AP-Elektronica-ICT/iot18-EP/README.md

# Internet of Things - Logistiek Tracking (Naam WIP)

## Groepsleden
Geentjens Wim - Trackingsoftware developer  
Knaepkens Tom - Team leader + Trackinghardware developer  
Scheyltjens Yorick - Backend webdeveloper  
Cools Jens - Frontend webdeveloper  

## Documentatie

Leg hier de link naar de nuttige documentatie
