AP-Elektronica-ICT/iot18-EP/doc/Diagrammen/HardwareFlowchart.png

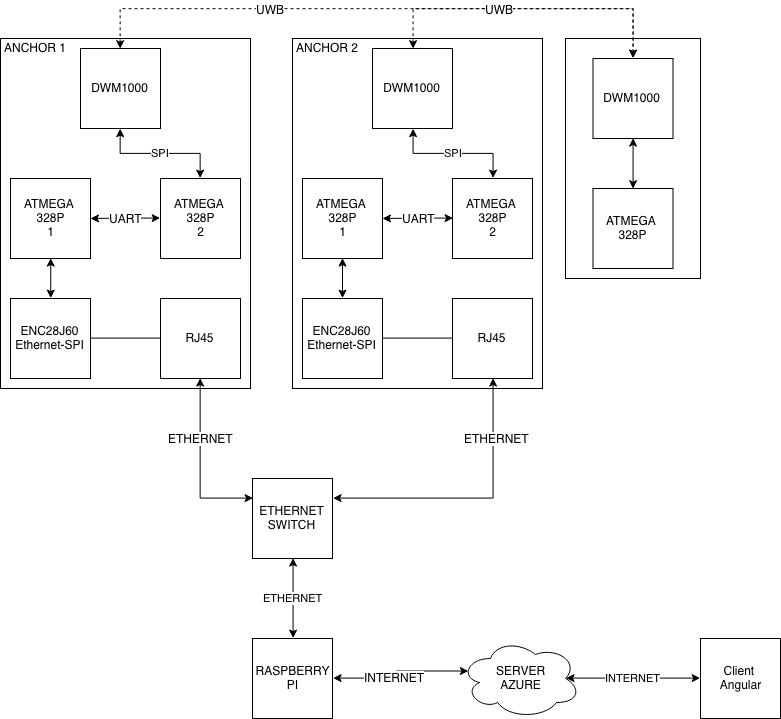
doc/Diagrammen/HardwareFlowchart.png
