AP-Elektronica-ICT/iot18-EP/src/Client/Plattegrond.png

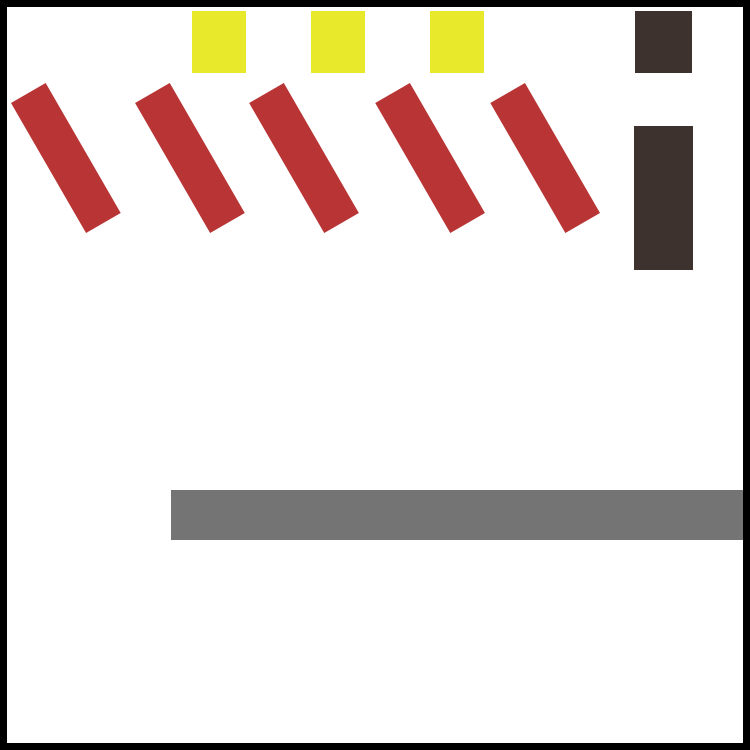
src/Client/Plattegrond.png
