AP-Elektronica-ICT/iot18-EP/src/Client/src/assets/images/map.PNG

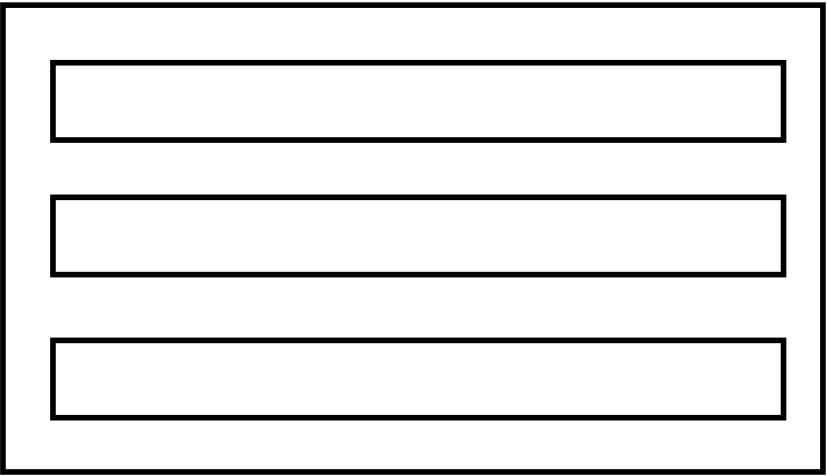
src/Client/src/assets/images/map.PNG
