AP-Elektronica-ICT/iot18-EP/src/DWM1000ConnectionSchematic.png

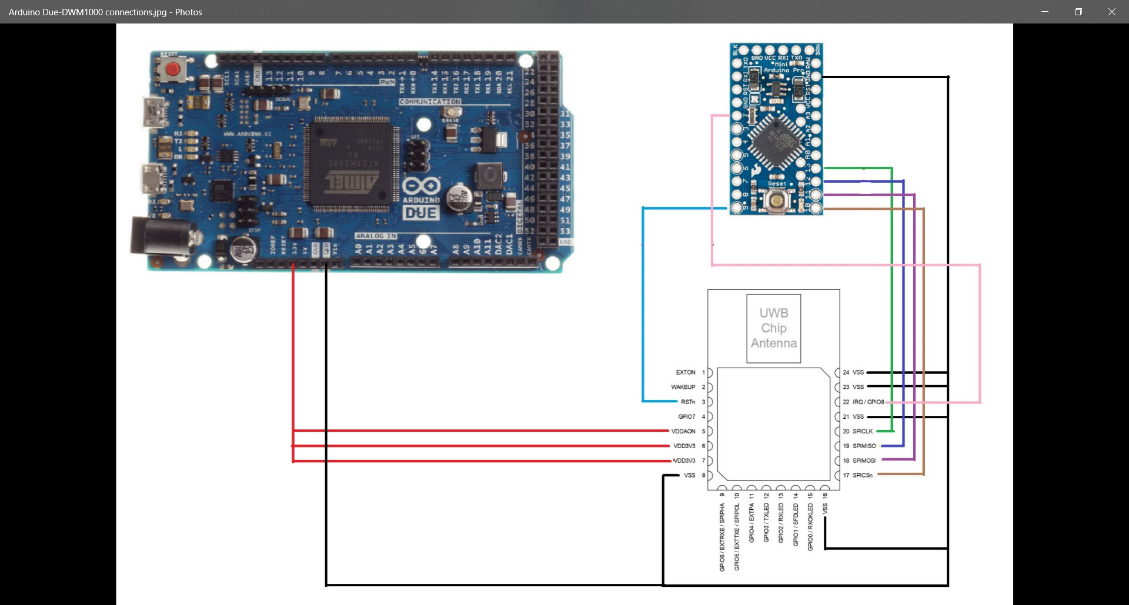
src/DWM1000ConnectionSchematic.png
