AP-Elektronica-ICT/iot18-EP/src/Anchor/PCB/Onderdelenlijst.xlsx

Onderdeel | Waarde | Package | Al in bezit | Juist package check | Eigen/School | Beschrijving | Opmerking
C1 | 100nF | SMD0805 | NEE | JA | SCHOOL | Aan RJ45
C2 | 100nF | SMD0805 | NEE | JA | SCHOOL | Aan RJ45
C3 | 18pF | SMD0805 | JA | JA | SCHOOL | Crystal ATMEGA1
C4 | 18pF | SMD0805 | JA | JA | SCHOOL | Crystal ATMEGA1
C5 | 18pF | SMD0805 | JA | JA | SCHOOL | Crystal ATMEGA2
C6 | 18pF | SMD0805 | JA | JA | SCHOOL | Crystal ATMEGA2
C7 | 10uF | SMD0805 | NEE | JA | SCHOOL | VCAP ENC28J60
C8 | 18pF | SMD0805 | JA | JA | SCHOOL | Crystal ENCJ2860
C9 | 18pF | SMD0805 | JA | JA | SCHOOL | Crystal ENCJ2860
C10 | 100nF | SMD0805 | NEE | JA | SCHOOL | RESET ATMEGA1
C11 | 100nF | SMD0805 | NEE | JA | SCHOOL | RESET ATMEGA2
D1 | BLAUW | SMD1206 | JA | JA | EIGEN | POWER
D2 | ROOD | SMD1206 | JA | JA | EIGEN | STATUS
D3 | GEEL | SMD1206 | JA | JA | EIGEN | TX
D4 | GROEN | SMD1206 | JA | JA | EIGEN | RX
D5 | GEEL | SMD1206 | JA | JA | EIGEN | DWM-TX
D6 | GROEN | SMD1206 | JA | JA | EIGEN | DWM-RX
IC3 | ENC28J60 | SOP65P780X200-28N | JA | JA | SCHOOL | Ethernet IC
J1 | SI-50154-F | SI-50154-F | JA | JA | SCHOOL | Ethernet Jack
J2 | ISP PROG 1 | 2x3 Pinheader | NEE | JA | SCHOOL | ISP PROG 1
J3 | ISP PROG 2 | 2x3 Pinheader | NEE | JA | SCHOOL | ISP PROG 2
J4 | PJ102AH | PJ102AH | JA | JA | EIGEN | DC Jack
MCU 1 | ATMEGA328P-AU | QFP80P900X900X120-32N | NEE | JA | SCHOOL | ATMEGA1
MCU 2 | ATMEGA328P-AU | QFP80P900X900X120-32N | NEE | JA | SCHOOL | ATMEGA2
R1 | 100 | SMD0805 | JA | JA | SCHOOL | Led Magjack
R2 | 100 | SMD0805 | JA | JA | SCHOOL | Led Magjack
R3 | 49.9 | SMD1206 | JA | JA | SCHOOL | Ethernet schema
R4 | 49.9 | SMD1206 | JA | JA | SCHOOL | Ethernet schema
R5 | 49.9 | SMD1206 | JA | JA | SCHOOL | Ethernet schema
R6 | 49.9 | SMD1206 | JA | JA | SCHOOL | Ethernet schema
R7 | 10k | SMD0805 | NEE | JA | SCHOOL | RESET 1 PULLUP
R8 | 10k | SMD0805 | NEE | JA | SCHOOL | RESET 2 PULLUP
R9 | 10k | SMD0805 | NEE | JA | SCHOOL | IRQ Pulldown
R10 | 2k32 | SMD1206 | JA | JA | SCHOOL | RBIAS ENCJ2860
R11 | 330 | SMD0805 | NEE | JA | SCHOOL | SPI VOORSCHAKEL
R12 | 330 | SMD0805 | NEE | JA | SCHOOL | SPI VOORSCHAKEL
R13 | 330 | SMD0805 | NEE | JA | SCHOOL | SPI VOORSCHAKEL
R14 |  |  |  |  |  |  | Weggelaten
R15 |  |  |  |  |  |  | Weggelaten
R16 |  |  |  |  |  |  | Weggelaten
R17 | 470 | SMD1206 | JA | JA | EIGEN | R LED Power
R18 | 220 | SMD1206 | JA | JA | EIGEN | R LED RX
R19 | 270 | SMD1206 | JA | JA | EIGEN | R LED TX
R20 | 390 | SMD1206 | JA | JA | EIGEN | R LED STATUS
R21 | 270 | SMD1206 | JA | JA | EIGEN | R LED DWM-TX
R22 | 220 | SMD1206 | JA | JA | EIGEN | R LED DWM-RX
S1 | RESET 1 | MOMENTARY-SWITCH-SPST-PTH-6.0MM | JA | JA | EIGEN | Reset 1
S2 | RESET 2 | MOMENTARY-SWITCH-SPST-PTH-6.0MM | JA | JA | EIGEN | Reset 2
DC-STEPDOWN | DC-STEPDOWN | DC-STEPDOWN | JA | JA | EIGEN | Power module
DWM1000 | DWM1000 | DWM1000 | NEE | JA | SCHOOL | UWB Module
UART1 | UART1 | 1x6 Pinheader | JA | JA | EIGEN | UART1
UART2 | UART2 | 1x6 Pinheader | JA | JA | EIGEN | UART2
Y1 | 8MHz | HC49UP | NEE | JA | SCHOOL | Crystal ATMEGA1
Y2 | 8MHz | HC49UP | NEE | JA | SCHOOL | Crystal ATMEGA2
Y3 | 25MHz | HC49UP | NEE | JA | SCHOOL | Crystal ENCJ2860
