AP-Elektronica-ICT/iot18-EP/src/Tag/PCB/Onderdelenlijst.xlsx

Onderdeel | Waarde | Package | Al in bezit | Juist package check | Eigen/School
C1 | 18pF | SMD0805 | JA | JA | SCHOOL
C2 | 18pF | SMD0805 | JA | JA | SCHOOL
C3 | 100nF | SMD0805 | NEE | JA | SCHOOL
C4 | 100uF | 3.5-8 | JA | JA | SCHOOL
C5 | 10uF | 2.5-7 | JA | JA | SCHOOL
MCU 1 | ATMEGA328P-AU | QFP80P900X900X120-32N | NEE | JA | SCHOOL
J1 | ISP PROG | 2x3 Pinheader | JA | JA | SCHOOL
Q1 | 8MHz | HC49UP | NEE | JA | SCHOOL
R1 | 10k | SMD0805 | NEE | JA | SCHOOL
R2 | 10k | SMD0805 | NEE | JA | SCHOOL
S1 | RESET 1 | MOMENTARY-SWITCH-SPST-PTH-6.0MM | JA | JA | EIGEN
DWM1000 | DWM1000 | DWM1000 | JA | JA | SCHOOL
UART | UART | 1x6 Pinheader | JA | JA | SCHOOL
