AP-Elektronica-ICT/iot18-EP/src/Anchor/PCB/Anchor PCB V2.brd

## EAGLE design src/Anchor/PCB/Anchor PCB V2.brd (2018-12-08)

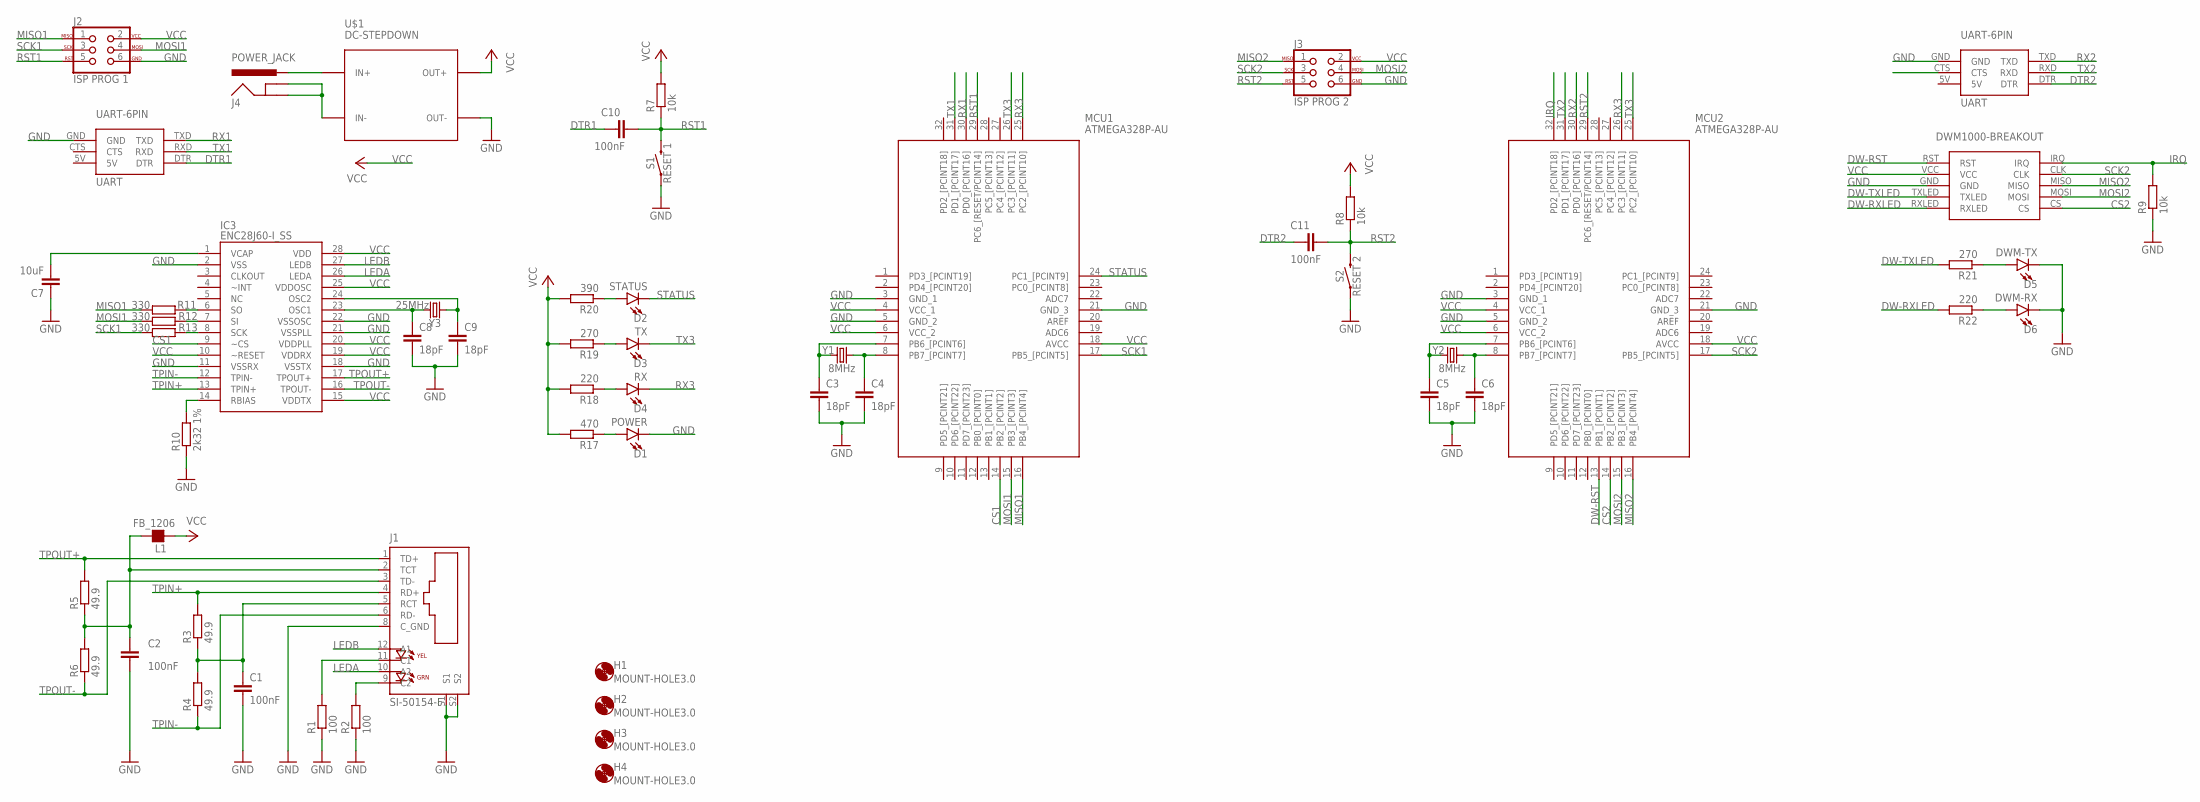
[picture p11: schematic Anchor PCB V2.sch]

Parts:
C1, C2, C10, C11: 100nF; C0805
C3, C4, C5, C6, C8, C9: 18pF; C0805
C7: 10uF; C0805
D1: POWER; LED-1206
D2: STATUS; LED-1206
D3: TX; LED-1206
D4: RX; LED-1206
D5: DWM-TX; LED-1206
D6: DWM-RX; LED-1206
H1, H2, H3, H4: MOUNT-HOLE3.0; 3,0
IC3: ENC28J60-I_SS; SOP65P780X200-28N
J1: SI-50154-F; STEWART_SI-50154-F
J2: ISP PROG 1; 2X3
J3: ISP PROG 2; 2X3
J4: POWER_JACK; POWER_JACK_PTH
L1: FB_1206; L1206
MCU1, MCU2: ATMEGA328P-AU; QFP80P900X900X120-32N
R1, R2: 100; R0805
R3, R4, R5, R6: 49.9; R1206
R7, R8, R9: 10k; R0805
R10: 2k32 1%; R1206
R11, R12, R13: 330; R0805
R17: 470; R1206
R18, R22: 220; R1206
R19, R21: 270; R1206
R20: 390; R1206
S1: RESET 1; TACTILE_SWITCH_PTH_6.0MM
S2: RESET 2; TACTILE_SWITCH_PTH_6.0MM
U$1: DC-STEPDOWN; DC-DC-STEP-DOWN-LM2596
U$2: DWM1000; DWM1000-BREAKOUT
UART1: UART1; UART-6PIN
UART2: UART2; UART-6PIN
Y1, Y2: 8MHz; HC49UP
Y3: 25MHz; HC49UP

Connections:
CS1: IC3.9 (~CS), MCU1.14 (PB2_[PCINT2])
CS2: MCU2.14 (PB2_[PCINT2]), U$2.CS
DTR1: C10.1, UART1.DTR
DTR2: C11.1, UART2.DTR
DW-RST: MCU2.13 (PB1_[PCINT1]), U$2.RST
DW-RXLED: R22.2, U$2.RXLED
DW-TXLED: R21.2, U$2.TXLED
GND: C1.2, C2.2, C3.2, C4.2, C5.2, C6.2, C7.1, C8.2, C9.2, D1.C, D5.C, D6.C, IC3.2 (VSS), IC3.11 (VSSRX), IC3.18 (VSSTX), IC3.21 (VSSPLL), IC3.22 (VSSOSC), J1.8 (C_GND), J1.S1, J1.S2, J2.6, J3.6, MCU1.3 (GND_1), MCU1.5 (GND_2), MCU1.21 (GND_3), MCU2.3 (GND_1), MCU2.5 (GND_2), MCU2.21 (GND_3), R1.1, R2.1, R9.1, R10.1, S1.1, S2.1, U$1.OUT-, U$2.GND, UART1.GND, UART2.GND
IN+: J4.PWR, U$1.IN+
IN-: J4.GND, J4.GNDBREAK, U$1.IN-
IRQ: MCU2.32 (PD2_[PCINT18]), R9.2, U$2.IRQ
LEDA: IC3.26 (LEDA), J1.10 (A2)
LEDB: IC3.27 (LEDB), J1.12 (A1)
MISO1: J2.1, MCU1.16 (PB4_[PCINT4]), R11.2
MISO2: J3.1, MCU2.16 (PB4_[PCINT4]), U$2.MISO
MOSI1: J2.4, MCU1.15 (PB3_[PCINT3]), R12.2
MOSI2: J3.4, MCU2.15 (PB3_[PCINT3]), U$2.MOSI
unnamed: J1.11 (C1), R1.2
unnamed: J1.9 (C2), R2.2
unnamed: C3.1, MCU1.7 (PB6_[PCINT6]), Y1.2
unnamed: C4.1, MCU1.8 (PB7_[PCINT7]), Y1.1
unnamed: C5.1, MCU2.7 (PB6_[PCINT6]), Y2.1
unnamed: C6.1, MCU2.8 (PB7_[PCINT7]), Y2.2
unnamed: C7.2, IC3.1 (VCAP)
unnamed: IC3.14 (RBIAS), R10.2
unnamed: C8.1, IC3.23 (OSC1), Y3.2
unnamed: C9.1, IC3.24 (OSC2), Y3.1
unnamed: IC3.6 (SO), R11.1
unnamed: C1.1, J1.5 (RCT), R3.1, R4.2
unnamed: C2.1, J1.2 (TCT), L1.2, R5.1, R6.2
unnamed: IC3.7 (SI), R12.1
unnamed: IC3.8 (SCK), R13.1
unnamed: D5.A, R21.1
unnamed: D4.A, R18.1
unnamed: D2.A, R20.1
unnamed: D3.A, R19.1
unnamed: D6.A, R22.1
unnamed: D1.A, R17.1
RST1: C10.2, J2.5, MCU1.29 (PC6_[RESET/PCINT14]), R7.1, S1.3 (2)
RST2: C11.2, J3.5, MCU2.29 (PC6_[RESET/PCINT14]), R8.1, S2.3 (2)
RX1: MCU1.30 (PD0_[PCINT16]), UART1.TXD
RX2: MCU2.30 (PD0_[PCINT16]), UART2.TXD
RX3: D4.C, MCU1.25 (PC2_[PCINT10]), MCU2.26 (PC3_[PCINT11])
SCK1: J2.3, MCU1.17 (PB5_[PCINT5]), R13.2
SCK2: J3.3, MCU2.17 (PB5_[PCINT5]), U$2.CLK
STATUS: D2.C, MCU1.24 (PC1_[PCINT9])
TPIN+: IC3.13 (TPIN+), J1.4 (RD+), R3.2
TPIN-: IC3.12 (TPIN-), J1.6 (RD-), R4.1
TPOUT+: IC3.17 (TPOUT+), J1.1 (TD+), R5.2
TPOUT-: IC3.16 (TPOUT-), J1.3 (TD-), R6.1
TX1: MCU1.31 (PD1_[PCINT17]), UART1.RXD
TX2: MCU2.31 (PD1_[PCINT17]), UART2.RXD
TX3: D3.C, MCU1.26 (PC3_[PCINT11]), MCU2.25 (PC2_[PCINT10])
VCC: IC3.10 (~RESET), IC3.15 (VDDTX), IC3.19 (VDDRX), IC3.20 (VDDPLL), IC3.25 (VDDOSC), IC3.28 (VDD), J2.2, J3.2, L1.1, MCU1.4 (VCC_1), MCU1.6 (VCC_2), MCU1.18 (AVCC), MCU2.4 (VCC_1), MCU2.6 (VCC_2), MCU2.18 (AVCC), R7.2, R8.2, R17.2, R18.2, R19.2, R20.2, U$1.OUT+, U$2.VCC

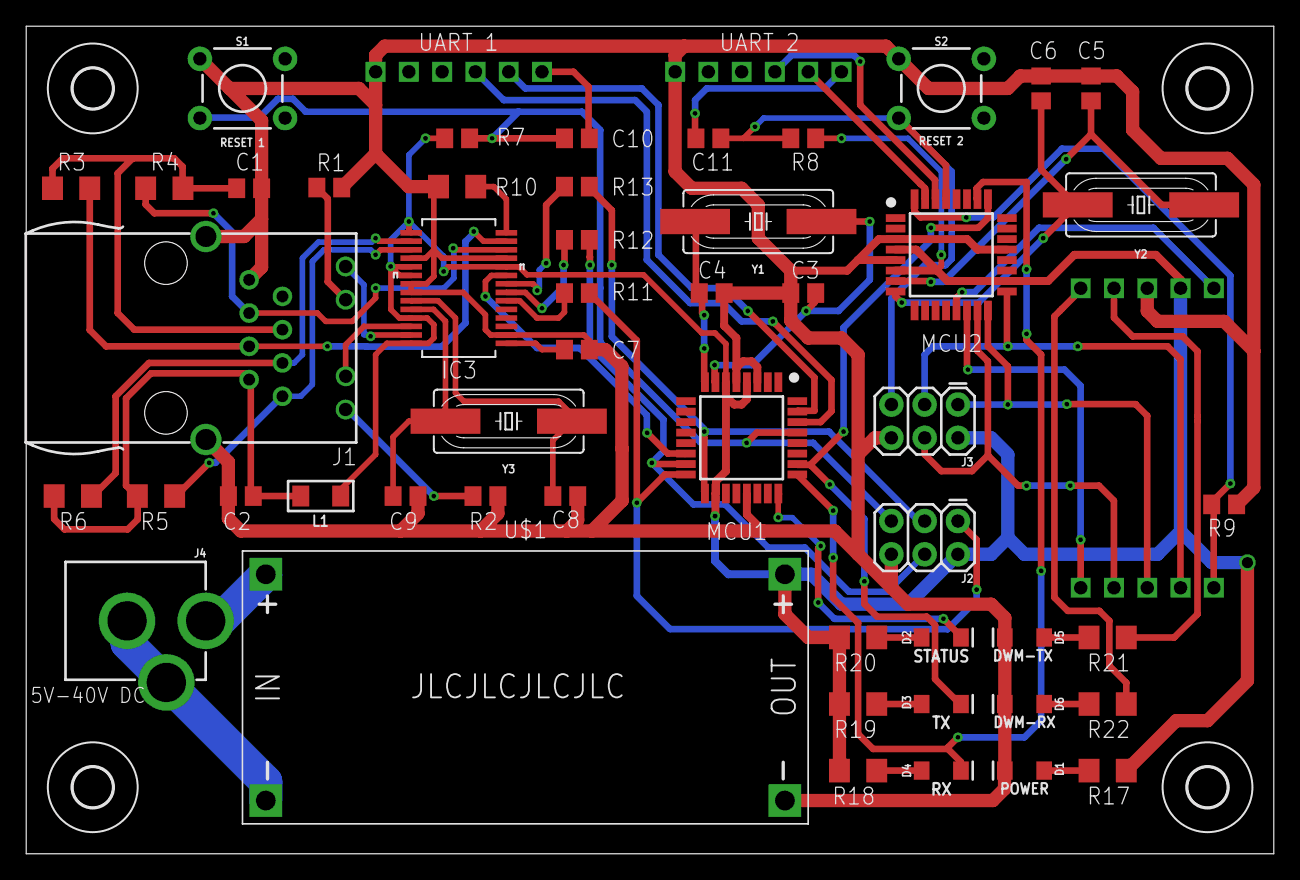
[picture p12: board Anchor PCB V2.brd from above]

Board: 2 copper layers, 95.2 x 63.2 mm, 57 parts (0 on the bottom side), 54 nets.
