AP-Elektronica-ICT/iot18-EP/src/DC-DC DIY/DC-DC DIY/Schematic.brd

## EAGLE design src/DC-DC DIY/DC-DC DIY/Schematic.brd (2018-12-08)

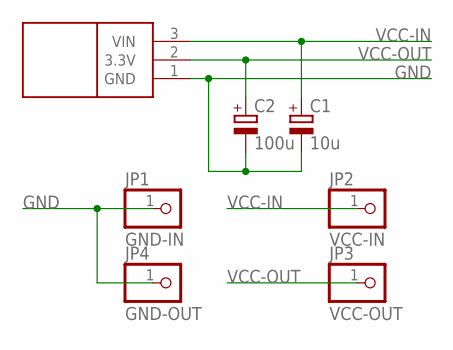
[picture p13: schematic Schematic.sch]

Parts:
C1: 10u; E2,5-7
C2: 100u; E3,5-8
JP1: GND-IN; 1X01
JP2: VCC-IN; 1X01
JP3: VCC-OUT; 1X01
JP4: GND-OUT; 1X01
U$1: LD33VHORIZONTAL; TO220

Connections:
GND: C1.-, C2.-, JP1.1, JP4.1, U$1.1 (GND)
VCC-IN: C1.+, JP2.1, U$1.3 (VIN)
VCC-OUT: C2.+, JP3.1, U$1.2 (3.3V)

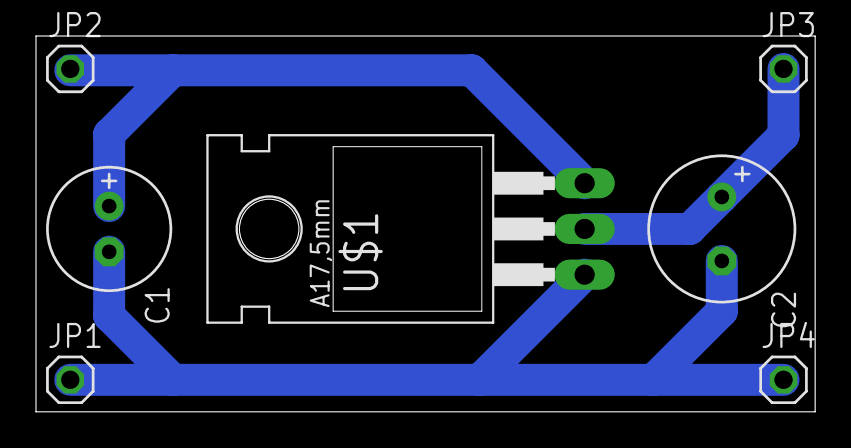
[picture p14: board src/DC-DC DIY/DC-DC DIY/Schematic.brd from above]

Board: 2 copper layers, 43.3 x 20.9 mm, 7 parts (0 on the bottom side), 3 nets.
