AP-Elektronica-ICT/iot18-EP/src/DWM1000 Breakout PCB/DWM1000 Breakout/Schematic.brd

## EAGLE design src/DWM1000 Breakout PCB/DWM1000 Breakout/Schematic.brd (2018-10-24, an earlier design)

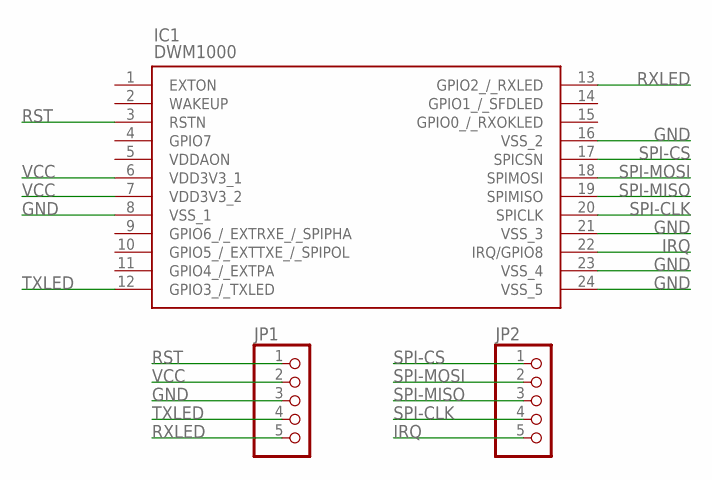
[picture p15: schematic Schematic.sch]

Parts:
IC1: DWM1000
JP1, JP2: PINHD-1X5; 1X05

Connections:
GND: IC1.8 (VSS_1), IC1.16 (VSS_2), IC1.21 (VSS_3), IC1.23 (VSS_4), IC1.24 (VSS_5), JP1.3
IRQ: IC1.22 (IRQ/GPIO8), JP2.5
RST: IC1.3 (RSTN), JP1.1
RXLED: IC1.13 (GPIO2_/_RXLED), JP1.5
SPI-CLK: IC1.20 (SPICLK), JP2.4
SPI-CS: IC1.17 (SPICSN), JP2.1
SPI-MISO: IC1.19 (SPIMISO), JP2.3
SPI-MOSI: IC1.18 (SPIMOSI), JP2.2
TXLED: IC1.12 (GPIO3_/_TXLED), JP1.4
VCC: IC1.6 (VDD3V3_1), IC1.7 (VDD3V3_2), JP1.2

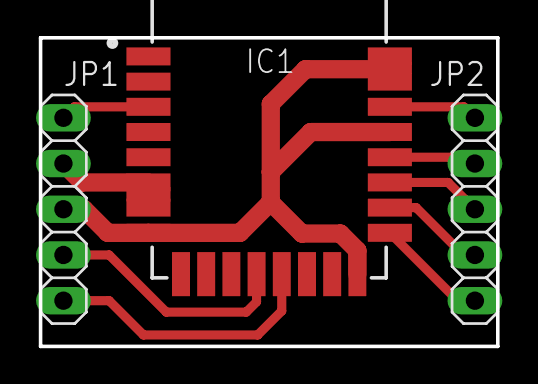
[picture p16: board src/DWM1000 Breakout PCB/DWM1000 Breakout/Schematic.brd from above]

Board: 2 copper layers, 25.4 x 17.1 mm, 3 parts (0 on the bottom side), 10 nets.
