AP-Elektronica-ICT/iot18-EP/src/Tag/PCB/Tag PCB V1.sch

## EAGLE design src/Tag/PCB/Tag PCB V1.sch (2018-11-14)

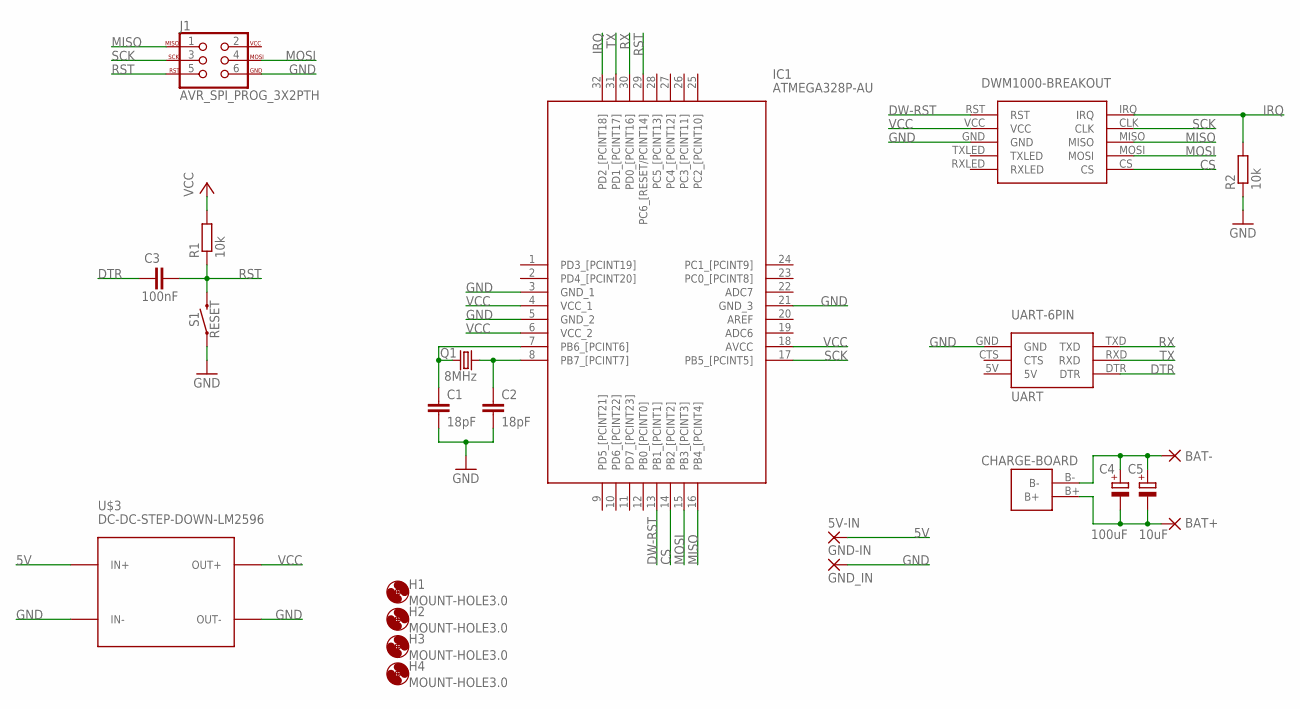
[picture p17: schematic Tag PCB V1.sch]

Parts:
5V-IN: 2,15/1,0
BAT+: 2,15/1,0
BAT-: 2,15/1,0
C1, C2: 18pF; C0805
C3: 100nF; C0805
C4: 100uF; E3,5-8
C5: 10uF; E2,5-7
GND-IN: GND_IN; 2,15/1,0
H1, H2, H3, H4: MOUNT-HOLE3.0; 3,0
IC1: ATMEGA328P-AU; QFP80P900X900X120-32N
J1: AVR_SPI_PROG_3X2PTH; 2X3
Q1: 8MHz; HC49UP
R1, R2: 10k; R0805
S1: RESET; TACTILE_SWITCH_PTH_6.0MM
U$1: DWM1000-BREAKOUT
U$2: UART-6PIN
U$3: DC-DC-STEP-DOWN-LM2596
U$4: 18650-CHARGE-5V-OUT

Connections:
5V: 5V-IN.1, U$3.IN+
CS: IC1.14 (PB2_[PCINT2]), U$1.CS
DTR: C3.1, U$2.DTR
DW-RST: IC1.13 (PB1_[PCINT1]), U$1.RST
GND: C1.2, C2.2, GND-IN.1, IC1.3 (GND_1), IC1.5 (GND_2), IC1.21 (GND_3), J1.6, R2.1, S1.1, U$1.GND, U$2.GND, U$3.IN-, U$3.OUT-
IRQ: IC1.32 (PD2_[PCINT18]), R2.2, U$1.IRQ
MISO: IC1.16 (PB4_[PCINT4]), J1.1, U$1.MISO
MOSI: IC1.15 (PB3_[PCINT3]), J1.4, U$1.MOSI
unnamed: BAT-.1, C4.+, C5.+, U$4.B-
unnamed: BAT+.1, C4.-, C5.-, U$4.B+
unnamed: C2.1, IC1.8 (PB7_[PCINT7]), Q1.2
unnamed: C1.1, IC1.7 (PB6_[PCINT6]), Q1.1
RST: C3.2, IC1.29 (PC6_[RESET/PCINT14]), J1.5, R1.1, S1.3 (2)
RX: IC1.30 (PD0_[PCINT16]), U$2.TXD
SCK: IC1.17 (PB5_[PCINT5]), J1.3, U$1.CLK
TX: IC1.31 (PD1_[PCINT17]), U$2.RXD
VCC: IC1.4 (VCC_1), IC1.6 (VCC_2), IC1.18 (AVCC), R1.2, U$1.VCC, U$3.OUT+

Notes on the sheet:
CHARGE-BOARD
