AP-Elektronica-ICT/iot18-EP/src/Anchor/Software/AnchorV3/AnchorV3.ino

#include <SPI.h>
#include <DW1000.h>
#include <EtherCard.h>


//Ethernet 
static byte mymac[] = { 0x74, 0x69, 0x69, 0x2D, 0x30, 0x31 };
static byte myip[] = { 192, 168, 3, 3 }; //IP
static byte gwip[] = { 192, 168, 3, 2 }; //Gateway
static byte hisip[] = { 192, 168, 3, 2   }; //Destination
const char website[] PROGMEM = "192.168.3.2"; //Destination
byte Ethernet::buffer[300];   // a very small tcp/ip buffer is enough here
Stash stash;
static long timer;
static byte session;



// connection pins
const uint8_t PIN_RST = 9; // reset pin
const uint8_t PIN_IRQ = 2; // irq pin
const uint8_t PIN_SS = SS; // spi select pin

// messages used in the ranging protocol
// TODO replace by enum
#define POLL 0
#define POLL_ACK 1
#define RANGE 2
#define RANGE_REPORT 3
#define RANGE_FAILED 255
// message flow state
volatile byte expectedMsgId = POLL;
// message sent/received state
volatile boolean sentAck = false;
volatile boolean receivedAck = false;
// protocol error state
boolean protocolFailed = false;
// timestamps to remember
DW1000Time timePollSent;
DW1000Time timePollReceived;
DW1000Time timePollAckSent;
DW1000Time timePollAckReceived;
DW1000Time timeRangeSent;
DW1000Time timeRangeReceived;
// last computed range/time
DW1000Time timeComputedRange;
// data buffer
#define LEN_DATA 17
byte data[LEN_DATA];
// watchdog and reset period
uint32_t lastActivity;
uint32_t resetPeriod = 250;
// reply times (same on both sides for symm. ranging)
uint16_t replyDelayTimeUS = 3000;
// ranging counter (per second)
uint16_t successRangingCount = 0;
uint32_t rangingCountPeriod = 0;
float samplingRate = 0;
int teller = 0;

void sendPacket() {

  byte sd = stash.create();
  stash.print("{");
  
  stash.print("\"MAC_TAG\":");
  stash.print("\"02\"");
  stash.print(",");
  stash.print("\"MAC_ANCHOR\":");
  stash.print("\"0x74, 0x69, 0x69, 0x2D, 0x30, 0x31\"");
  stash.print(",");
  stash.print("\"DISTANCE\":");
  stash.print(teller);
  
  stash.print("}");
  stash.save();
  Stash::prepare(PSTR("POST https://$F HTTP/1.1" "\r\n"
                      "Host: $F" "\r\n"
                       "Content-Length: $D" "\r\n"
                       "Content-Type: application/json" "\r\n"
                       "\r\n"
                       "$H"),
                 website, website, stash.size(), sd);
  ether.tcpSend();
  teller++;

  
  Serial.println("Packet Send");

}


void setup() {
  // DEBUG monitoring
  Serial.begin(115200);
  delay(1000);
  Serial.println(F("### DW1000-arduino-ranging-anchor ###"));
  // initialize the driver
  DW1000.begin(PIN_IRQ, PIN_RST);
  DW1000.select(PIN_SS);
  Serial.println(F("DW1000 initialized ..."));
  // general configuration
  DW1000.newConfiguration();
  DW1000.setDefaults();
  DW1000.setDeviceAddress(1);
  DW1000.setNetworkId(10);
  DW1000.enableMode(DW1000.MODE_LONGDATA_RANGE_LOWPOWER);
  DW1000.commitConfiguration();
  Serial.println(F("Committed configuration ..."));
  // DEBUG chip info and registers pretty printed
  char msg[128];
  DW1000.getPrintableDeviceIdentifier(msg);
  Serial.print("Device ID: "); Serial.println(msg);
  DW1000.getPrintableExtendedUniqueIdentifier(msg);
  Serial.print("Unique ID: "); Serial.println(msg);
  DW1000.getPrintableNetworkIdAndShortAddress(msg);
  Serial.print("Network ID & Device Address: "); Serial.println(msg);
  DW1000.getPrintableDeviceMode(msg);
  Serial.print("Device mode: "); Serial.println(msg);
  // attach callback for (successfully) sent and received messages
  DW1000.attachSentHandler(handleSent);
  DW1000.attachReceivedHandler(handleReceived);
  // anchor starts in receiving mode, awaiting a ranging poll message
  receiver();
  noteActivity();
  // for first time ranging frequency computation
  rangingCountPeriod = millis();

  // Ethernet
  if (ether.begin(sizeof Ethernet::buffer, mymac) == 0)
    Serial.println( "Failed to access Ethernet controller");

  ether.staticSetup(myip, gwip);
  ether.copyIp(ether.hisip, hisip);
  ether.printIp("Server: ", ether.hisip);

}

void noteActivity() {
  // update activity timestamp, so that we do not reach "resetPeriod"
  lastActivity = millis();
}

void resetInactive() {
  // anchor listens for POLL
  expectedMsgId = POLL;
  receiver();
  noteActivity();
}

void handleSent() {
  // status change on sent success
  sentAck = true;
}

void handleReceived() {
  // status change on received success
  receivedAck = true;
}

void transmitPollAck() {
  DW1000.newTransmit();
  DW1000.setDefaults();
  data[0] = POLL_ACK;
  // delay the same amount as ranging tag
  DW1000Time deltaTime = DW1000Time(replyDelayTimeUS, DW1000Time::MICROSECONDS);
  DW1000.setDelay(deltaTime);
  DW1000.setData(data, LEN_DATA);
  DW1000.startTransmit();
}

void transmitRangeReport(float curRange) {
  DW1000.newTransmit();
  DW1000.setDefaults();
  data[0] = RANGE_REPORT;
  // write final ranging result
  memcpy(data + 1, &curRange, 4);
  DW1000.setData(data, LEN_DATA);
  DW1000.startTransmit();
}

void transmitRangeFailed() {
  DW1000.newTransmit();
  DW1000.setDefaults();
  data[0] = RANGE_FAILED;
  DW1000.setData(data, LEN_DATA);
  DW1000.startTransmit();
}

void receiver() {
  DW1000.newReceive();
  DW1000.setDefaults();
  // so we don't need to restart the receiver manually
  DW1000.receivePermanently(true);
  DW1000.startReceive();
}

/*
   RANGING ALGORITHMS
   ------------------
   Either of the below functions can be used for range computation (see line "CHOSEN
   RANGING ALGORITHM" in the code).
   - Asymmetric is more computation intense but least error prone
   - Symmetric is less computation intense but more error prone to clock drifts

   The anchors and tags of this reference example use the same reply delay times, hence
   are capable of symmetric ranging (and of asymmetric ranging anyway).
*/

void computeRangeAsymmetric() {
  // asymmetric two-way ranging (more computation intense, less error prone)
  DW1000Time round1 = (timePollAckReceived - timePollSent).wrap();
  DW1000Time reply1 = (timePollAckSent - timePollReceived).wrap();
  DW1000Time round2 = (timeRangeReceived - timePollAckSent).wrap();
  DW1000Time reply2 = (timeRangeSent - timePollAckReceived).wrap();
  DW1000Time tof = (round1 * round2 - reply1 * reply2) / (round1 + round2 + reply1 + reply2);
  // set tof timestamp
  timeComputedRange.setTimestamp(tof);
}

void computeRangeSymmetric() {
  // symmetric two-way ranging (less computation intense, more error prone on clock drift)
  DW1000Time tof = ((timePollAckReceived - timePollSent) - (timePollAckSent - timePollReceived) +
                    (timeRangeReceived - timePollAckSent) - (timeRangeSent - timePollAckReceived)) * 0.25f;
  // set tof timestamp
  timeComputedRange.setTimestamp(tof);
}

/*
   END RANGING ALGORITHMS
   ----------------------
*/

void loop() {
  /*
  int32_t curMillis = millis();
  if (!sentAck && !receivedAck) {
    // check if inactive
    if (curMillis - lastActivity > resetPeriod) {
      resetInactive();
    }
    return;
  }
  // continue on any success confirmation
  if (sentAck) {
    sentAck = false;
    byte msgId = data[0];
    if (msgId == POLL_ACK) {
      DW1000.getTransmitTimestamp(timePollAckSent);
      noteActivity();
    }
  }
  if (receivedAck) {
    receivedAck = false;
    // get message and parse
    DW1000.getData(data, LEN_DATA);
    //for(int x=0; x<LEN_DATA; x++){
    //  Serial.print(data[x]);
    //  Serial.print(" ");
    //}
    //Serial.println();

    byte msgId = data[0];
    if (msgId != expectedMsgId) {
      // unexpected message, start over again (except if already POLL)
      protocolFailed = true;
    }
    if (msgId == POLL) {
      // on POLL we (re-)start, so no protocol failure
      protocolFailed = false;
      DW1000.getReceiveTimestamp(timePollReceived);
      expectedMsgId = RANGE;
      transmitPollAck();
      noteActivity();
    }
    else if (msgId == RANGE) {
      DW1000.getReceiveTimestamp(timeRangeReceived);
      expectedMsgId = POLL;
      if (!protocolFailed) {
        timePollSent.setTimestamp(data + 1);
        timePollAckReceived.setTimestamp(data + 6);
        timeRangeSent.setTimestamp(data + 11);
        // (re-)compute range as two-way ranging is done
        computeRangeAsymmetric(); // CHOSEN RANGING ALGORITHM
        transmitRangeReport(timeComputedRange.getAsMicroSeconds());
        float distance = timeComputedRange.getAsMeters();
        Serial.print("Tag ");
        Serial.print(data[16]);
        Serial.print(": "); Serial.print(distance); Serial.println(" m");
        //Serial.print("\t RX power: "); Serial.print(DW1000.getReceivePower()); Serial.println(" dBm");
        //Serial.print("\t Sampling: "); Serial.print(samplingRate); Serial.println(" Hz");
        //Serial.print("FP power is [dBm]: "); Serial.println(DW1000.getFirstPathPower());
        //Serial.print("RX power is [dBm]: "); Serial.println(DW1000.getReceivePower());
        //Serial.print("Receive quality: "); Serial.println(DW1000.getReceiveQuality());
        // update sampling rate (each second)
        successRangingCount++;
        if (curMillis - rangingCountPeriod > 1000) {
          samplingRate = (1000.0f * successRangingCount) / (curMillis - rangingCountPeriod);
          rangingCountPeriod = curMillis;
          successRangingCount = 0;
        }
      }
      else {
        transmitRangeFailed();
      }

      noteActivity();
    }
  }
*/
  ether.packetLoop(ether.packetReceive());

  const char* reply = ether.tcpReply(session);
  if (reply != 0) {
    Serial.println("Got a response!");
    Serial.println(reply);
  }

  if (millis() > timer + 3000) {
    timer = millis();
    sendPacket();
  }

  
}
