AP-Elektronica-ICT/iot18-EP/src/Anchor/Software/UDP_Test/UDP_Test.ino

#include <EtherCard.h>

// ethernet interface mac address, must be unique on the LAN
static byte mymac[] = { 0x74,0x69,0x69,0x2D,0x30,0x31 };
static byte myip[] = { 192,168,3,3 };
byte Ethernet::buffer[700];
static uint32_t timer;

const char website[] PROGMEM = "server.example.net";
const int dstPort PROGMEM = 1234;

const int srcPort PROGMEM = 4321;

void setup () {
  Serial.begin(9600);

  // Change 'SS' to your Slave Select pin, if you arn't using the default pin
  if (ether.begin(sizeof Ethernet::buffer, mymac, SS) == 0)
    Serial.println( "Failed to access Ethernet controller");
  ether.staticSetup(myip);

  ether.printIp("IP:  ", ether.myip);
  ether.printIp("GW:  ", ether.gwip);
  ether.printIp("DNS: ", ether.dnsip);

  if (!ether.dnsLookup(website))
    Serial.println("DNS failed");

  ether.printIp("SRV: ", ether.hisip);
}

char textToSend[] = "test 123";

void loop () {
    if (millis() > timer) {
      timer = millis() + 5000;
     //static void sendUdp (char *data,uint8_t len,uint16_t sport, uint8_t *dip, uint16_t dport);
     ether.sendUdp(textToSend, sizeof(textToSend), srcPort, ether.hisip, dstPort );
  }
}
