AP-Elektronica-ICT/iot18-EP/(commit log)

2018-09-27 added architecture schematics
2018-09-27 Added Fysiek Design and schematic product
2018-10-05 Added Hardware Flowchart
2018-10-05 Created Anchor PCB Schematic
    [Anchor PCB V1.sch]
2018-10-11 Breakout PCB added
    [Schematic.brd, Schematic.sch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]
2018-10-18 Anchor schematic V1 screenshot added
2018-10-23 .gitignore fix
    [Anchor PCB V1.sch, Schematic.brd, Schematic.sch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]
2018-10-23 .gitignore fix 2.0
    [Anchor PCB V1.sch, Schematic.brd, Schematic.sch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]
2018-10-24 Deleted unnecessary PCB files
    [Schematic.brd]
2018-10-24 Added full component list/inventory
    [Onderdelenlijst.xlsx]
2018-10-24 Edited Anchor PCB schematic + Board V1
    [Anchor PCB V2.brd, Anchor PCB V2.sch]
2018-10-27 Removed some unnecessary resistors in Anchor V2
    [Anchor PCB V2.brd, Anchor PCB V2.sch]
2018-10-27 Added Tag PCB V1
    [Tag PCB V1.sch]
2018-10-27 Removed unnecessary resistors from component list
    [Onderdelenlijst.xlsx]
2018-11-14 Timer toegevoegd
2018-11-14 PCB JLC tag added
    [Anchor PCB V2.brd, Anchor PCB V2.sch, Tag PCB V1.brd, Tag PCB V1.sch]
2018-11-14 Tag case added
    [TagCase.skp, TagCase~.skp]
2018-11-14 Moved Tag PCB to 0,0
2018-11-26 Partlist changed + added seperate Anchor sketches
    [Onderdelenlijst.xlsx]
2018-12-08 DC-DC Breakout board created
    [Schematic.brd, Schematic.sch]
2018-12-08 Updated partlist Tag
    [Onderdelenlijst.xlsx]
2018-12-08 Updated partlist Anchor
    [Onderdelenlijst.xlsx]
2018-12-08 Deleted CTS pin
    [Anchor PCB V2.brd, Anchor PCB V2.sch]
2018-12-23 Anchor case design V1 added
2018-12-23 Revert "MAC adress dynamisch gemaakt + meerdere anchors mogelijk"
    This reverts commit 795b303263730dc29949294aa32de9a3892c2424.
    [MCU1_Ethernet.ino, MCU2_DWM1000.ino]
2018-12-27 Anchor case V2 added
2018-12-27 Tag case Sketchup files deleted
    [TagCase.skp, TagCase~.skp]
2019-01-03 Tag case + gateway case added
2019-01-03 Anchor calibration added
2019-01-11 filter toegevoegd
2019-01-11 Anchor 3 hard reset
    [MCU2_DWM1000.ino]
2019-04-03 Raspberry Pi scripts toegevoegd
