AP-Elektronica-ICT/iot18-EP/(notices)

Notices in the files:
parts and their libraries:
SparkFun-LED: Licensing: Creative Commons ShareAlike 4.0 International - https://creativecommons.org/licenses/by-sa/4.0
rc-master-smd: Copyright (C) 2007, Bob Starr
